flat4power/Guepard/README.md

Guepard
=======

Guepard board for FreeEMS
