flat4power/Guepard/docs/Guepard.png

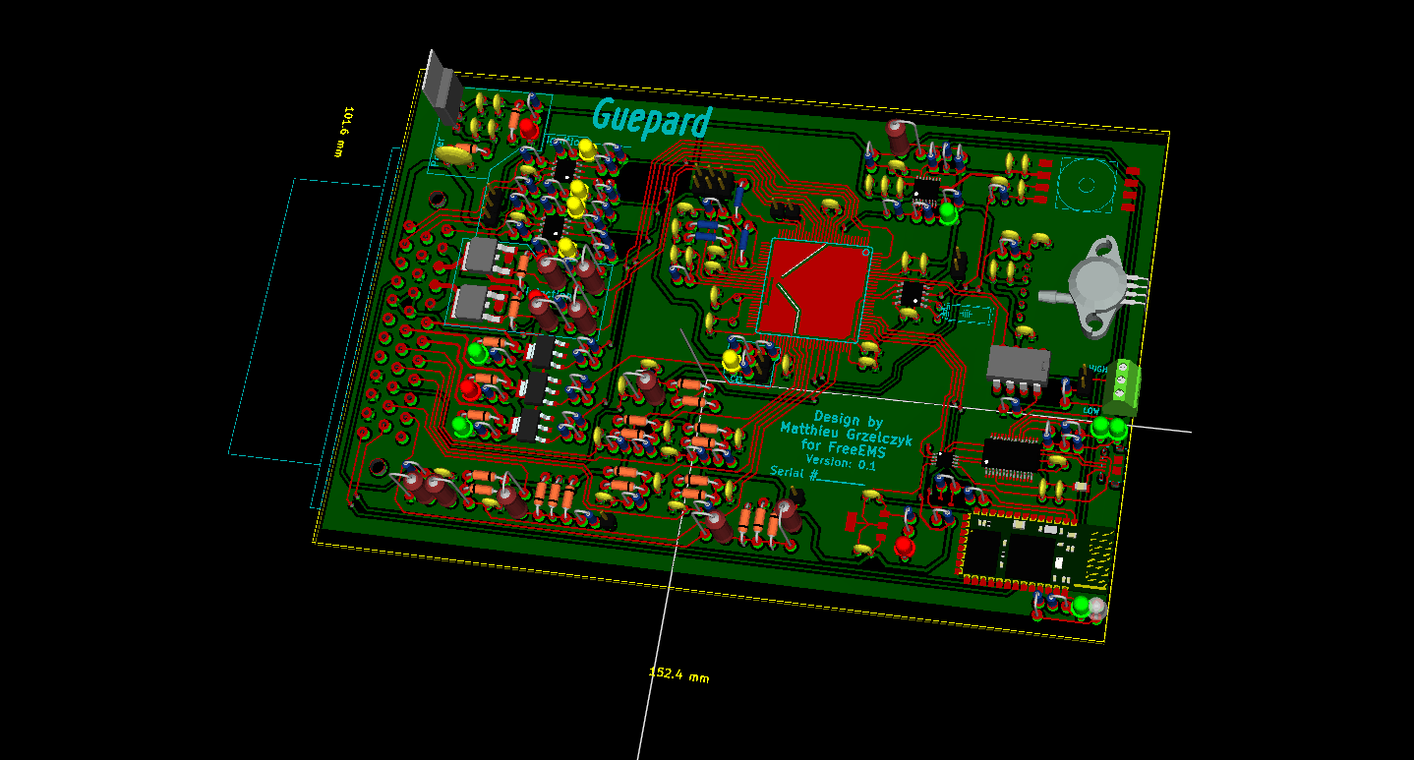
docs/Guepard.png
