flat4power/Guepard/docs/ignitors.PNG

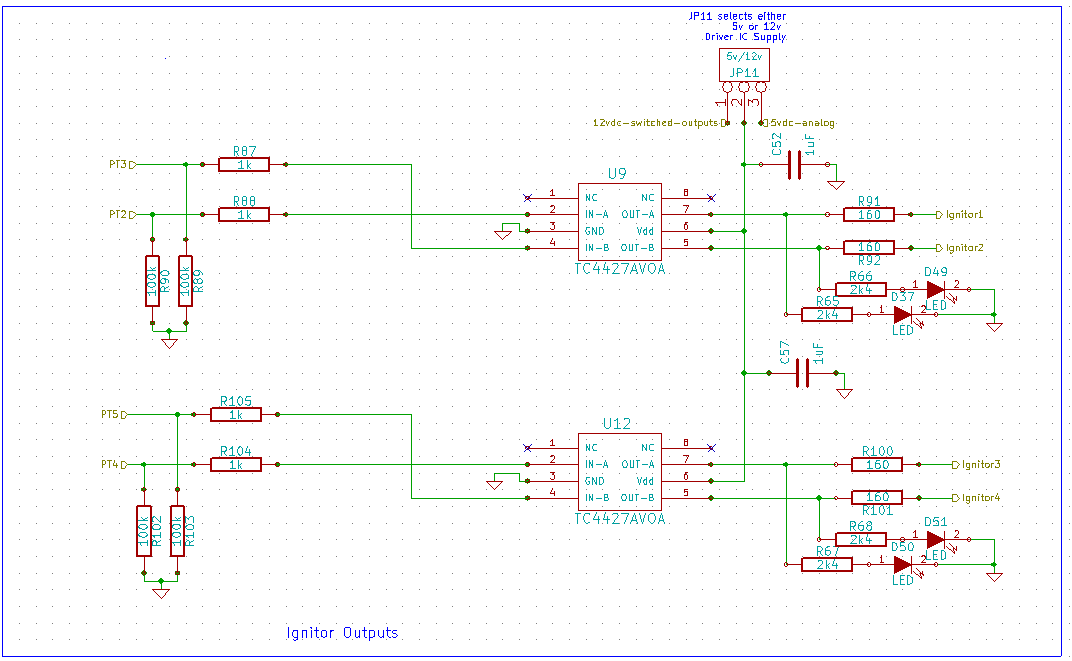
docs/ignitors.PNG
