flat4power/Guepard/docs/injectors.PNG

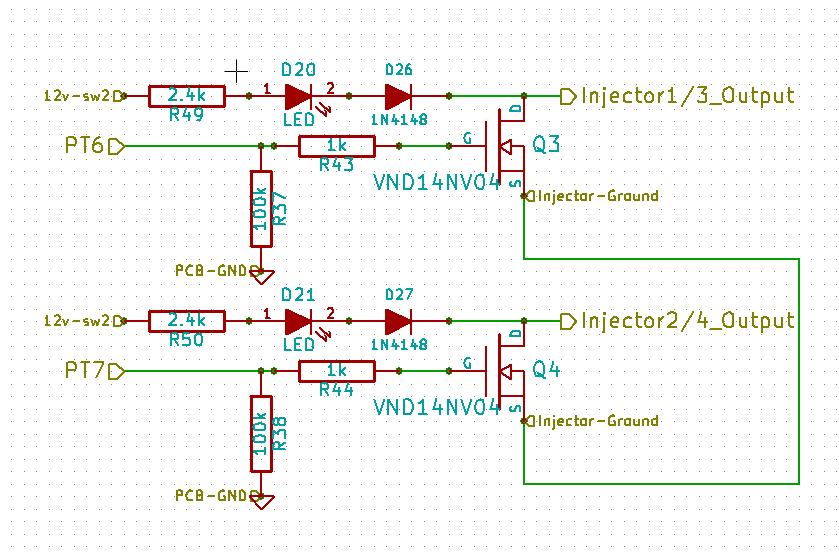
docs/injectors.PNG
