flat4power/Guepard/docs/injectors_3D.png

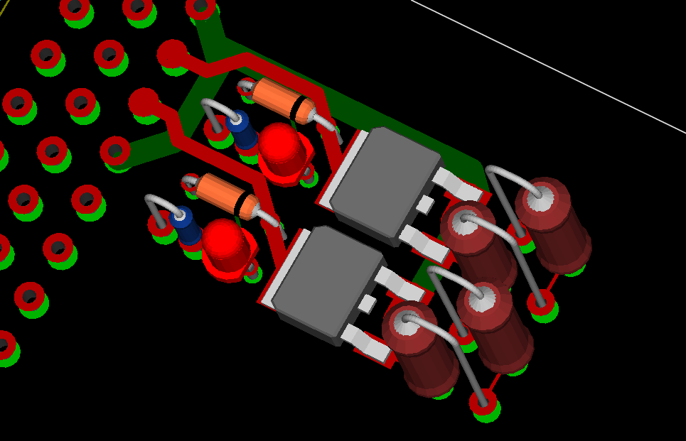
docs/injectors_3D.png
