flat4power/Guepard/docs/power.PNG

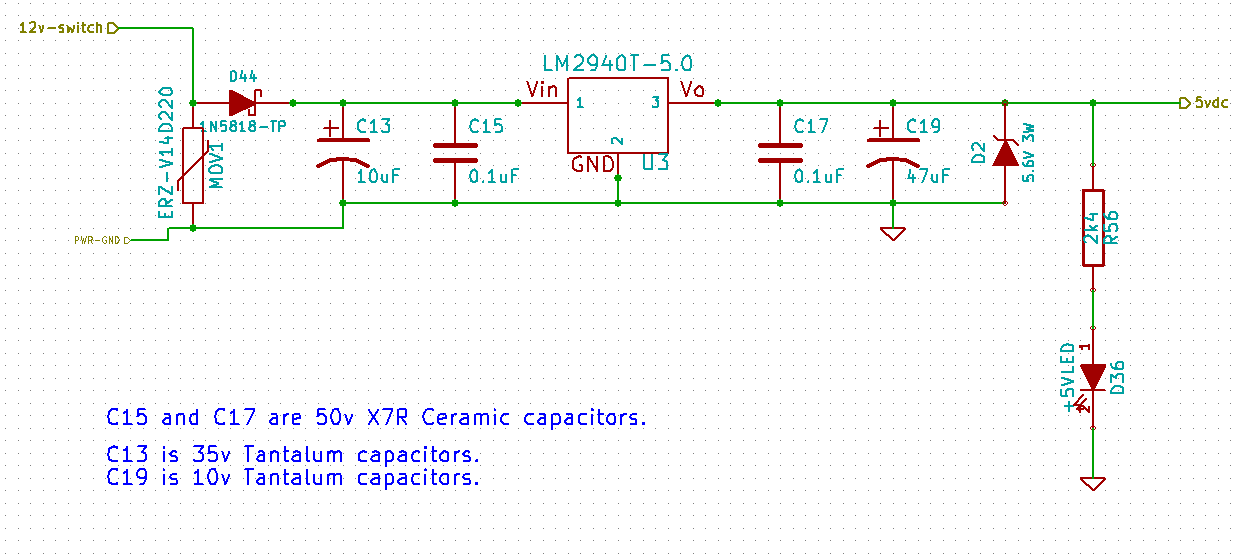
docs/power.PNG
