flat4power/Guepard/docs/power_3D.png

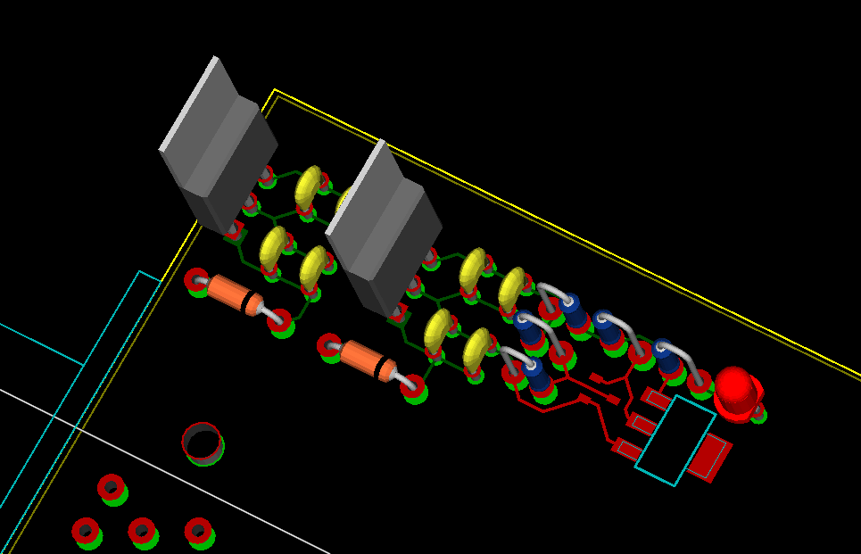
docs/power_3D.png
