flat4power/Guepard/(commit log)

2013-05-23 full update
    [Connector.sch, Digital-Inputs.sch, Guepard.dsn, Guepard.sch, Injectors.sch, Outputs.sch, PowerSupplies.sch, cpu.sch]
2013-05-28 change MAT to SPR input
    [Digital-Inputs.sch]
2013-05-28 Change CEL/Load Circuit (add a R10 1k resistor)
    [cpu.sch]
2013-05-28 replace TC442xa with TC4427
    [Outputs.sch]
2013-05-28 Communication Board
    [Guepard-Communication.kicad_pcb, Guepard-Communication.sch]
2013-06-19 delete communication board
    communication circuit nox include on main board
    [Guepard-Communication.kicad_pcb, Guepard-Communication.sch]
2013-06-19 schematics update
    [Digital-Inputs.sch, Guepard.sch, Injectors.sch, Outputs.sch, PowerSupplies.sch, cpu.sch, inputs.sch]
2013-06-19 communication update and PCB
    [Guepard-Communication.sch, Guepard.kicad_pcb]
2013-06-19 MPX4250 footprint
    [Digital-Inputs.sch, Guepard-Communication.sch, Guepard.sch, Injectors.sch, Outputs.sch, PowerSupplies.sch, cpu.sch, inputs.sch]
2013-06-27 replace M41T56M6 by DS1307ZN+
    remove keystone103 for RTC battery and replace it by 2 pin
    change MCP2551 soic8 to DIP8
    [Digital-Inputs.sch, Guepard-Communication.sch, Guepard.sch, Injectors.sch, Outputs.sch, PowerSupplies.sch, cpu.sch, inputs.sch]
2013-06-27 Ground plane under MCU - RPM traces - power capacitor for MCU
    The ground plane under the Freescale MCU should look like the suggested
    PCB design in the Freescale 9S12XDP512 datasheet
    [Guepard.kicad_pcb]
2013-07-02 deleted .bak
    [Guepard.dsn, Guepard.kicad_pcb]
2013-07-02 bluetooth level converter ADUM3201
    [Guepard-Communication.sch, Guepard.kicad_pcb, Guepard.sch]
2013-07-02 general update
    [Digital-Inputs.sch, Injectors.sch, Outputs.sch, PowerSupplies.sch, cpu.sch, inputs.sch]
